MainTechAI/Deep-Tech-Hackathon/rover_hatch.stl

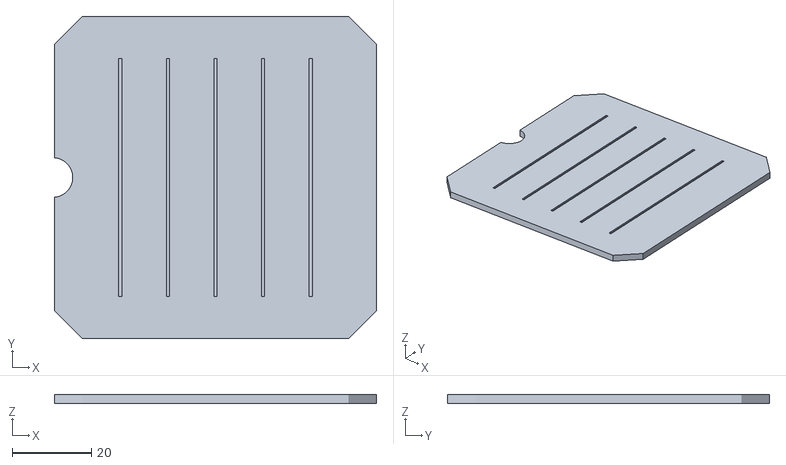
[picture p19: CAD file, 2026-10-11]
rover_hatch.stl
81.2 x 81.2 x 2.20
