MainTechAI/Deep-Tech-Hackathon/rover_shell.stl

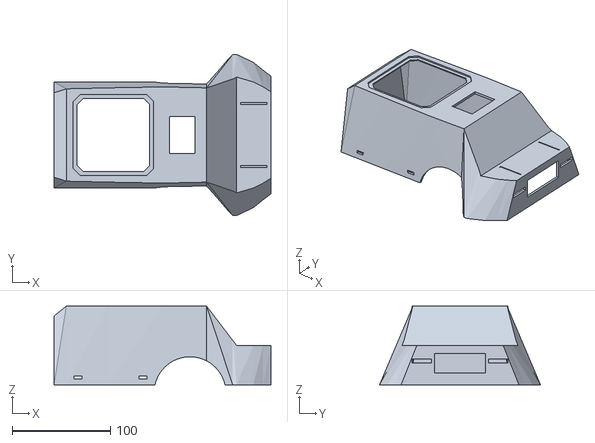
[picture p20: CAD file, 2026-10-11]
rover_shell.stl
221.0 x 164.0 x 80.0
