MainTechAI/Deep-Tech-Hackathon/vision_nav/print/markers.pdf

▲ robot front ▲

## #0 robot

black square = 10 cm

## #1 corner (0, 0)

black square = 13 cm

## #2 corner (W, 0)

black square = 13 cm

## #3 corner (W, H)

black square = 13 cm

## #4 corner (0, H)

black square = 13 cm

## #5 follow me

black square = 13 cm
