MainTechAI/Deep-Tech-Hackathon/vision_nav/firmware/rover/face.h

#pragma once

void faceBegin();
void showHappy();
void showSurprised();
void showUp();
void showDown();
void showLeft();
void showRight();
void showStop();
void showMotion(int left, int right);  // arrow matching the wheel speeds
void showNumber(int n);                // 0..999, e.g. last part of the IP address
