MainTechAI/Deep-Tech-Hackathon/(commit log)

2026-10-09 chassis info
2026-10-09 added info about motors
2026-10-10 Calibrate Wi-Fi signal seeking
2026-10-11 vision_nav: baseline rover firmware (Wi-Fi joystick, front safety, AUTO, RSSI follow)
    Modular UNO R4 WiFi firmware: movement API with front sonar safety and
    command timeouts, HTTP API + phone joystick page, buzzer parking sensor,
    LED matrix faces, AUTO obstacle avoidance and experimental RSSI follow.
    Tested on hardware: API suite passes, sensor and motors verified.
    [buzzer.cpp, buzzer.h, face.cpp, face.h, follow.cpp, follow.h, movement.cpp]
2026-10-11 vision_nav: navigation server with camera localisation, mapping and A* planning
    - app.py: robot TCP link (token auth), WebSocket for camera/console clients,
    10 Hz control loop
    - brain.py: marker-based pose, sonar occupancy mapping, goto/follow/home
    missions, path following, stuck detection, camera auto-calibration
    - planner.py: occupancy grid, obstacle inflation, virtual fence, A* + smoothing
    - geometry.py: 4-point homography image -> floor (works for oblique cameras)
    - sim.py: simulated rover + oblique camera for testing without hardware
    - web/vendor: js-aruco2 (BSD) for in-browser marker detection
2026-10-11 vision_nav: console, phone camera page and printable markers
    - web/index.html: live arena map (robot, path, trail, mapped obstacles,
    person, home), click-to-go, wall drawing, follow/home/calibrate, joystick
    - web/camera.html: in-browser ArUco detection on the phone camera, sends
    marker corners to the server, draws the planned path back onto the video
    - web/markers.html: printable markers at exact physical size
    - server: slow WebSocket clients can no longer stall the control loop,
    faster A*, follow mode turns to face the person when close
2026-10-11 vision_nav: robot <-> server link and Docker deployment
    - firmware/link.*: persistent outbound TCP link to the server (token auth),
    10 Hz telemetry, D/S/B commands, auto-reconnect, stops before reconnecting
    - deploy/: Dockerfile, compose (app + Caddy, host network), Caddyfile for
    HTTPS on 8443, deploy.sh (rsync + random secrets on first run)
2026-10-11 vision_nav: redesigned console, camera and marker pages; hide control key from URL
    - refined dark/light UI, map as the main element, STOP pinned on phones
    - the control key is stored and removed from the address bar on load
    - sim.py: camera link reads its WebSocket so server heartbeats keep it alive
2026-10-11 vision_nav: A4 marker sheet (13 cm corners, 10 cm robot) + ready-to-print PDF
2026-10-11 vision_nav: measure the arena size automatically from the corner markers' printed size
2026-10-11 vision_nav: pulse turning, stop-and-look on slow camera, live tuning panel
2026-10-11 vision_nav: straight-line wheel trim, set automatically by Calibrate
2026-10-11 vision_nav: settled turn pulses with automatic turn-direction detection; stable obstacle map
    - after each turn pulse wait for the delayed camera before deciding again (no overshoot)
    - if the robot keeps turning the wrong way (mirrored arena / motor wiring), flip the sign
    - confirmed obstacles are no longer erased by a passing sonar ray (route flip-flopping)
    - sim: camera latency and --reversed-turn
2026-10-11 vision_nav: fewer phantom obstacles - ignore arena edge and turning sweeps, 45 cm range, 3 echoes to confirm
2026-10-11 vision_nav: keep tuning and calibration across server restarts (data volume)
2026-10-11 vision_nav: turn around one wheel instead of spinning (smoother), arc for errors up to 50 deg
2026-10-11 vision_nav: turns only in pulses; gentle capped steering while driving; follow hold uses pulses
2026-10-11 vision_nav: keep the robot inside the arena - 20 cm fence, targets clamped, back off only with room behind, drive back into view when lost, plan back in from outside
2026-10-11 vision_nav: no staircase routes near the fence; skip path corners closer than 15 cm
2026-10-11 vision_nav: drive back into the arena when outside (forward or reverse towards the centre), lost recovery in pulses up to 3 s, close echoes always mapped, short calibration spin
2026-10-11 Rover body & hatch 3d models
    [rover_hatch.stl, rover_shell.stl]
